aobato/green_pomp4/水中ポンプ部品表.pdf

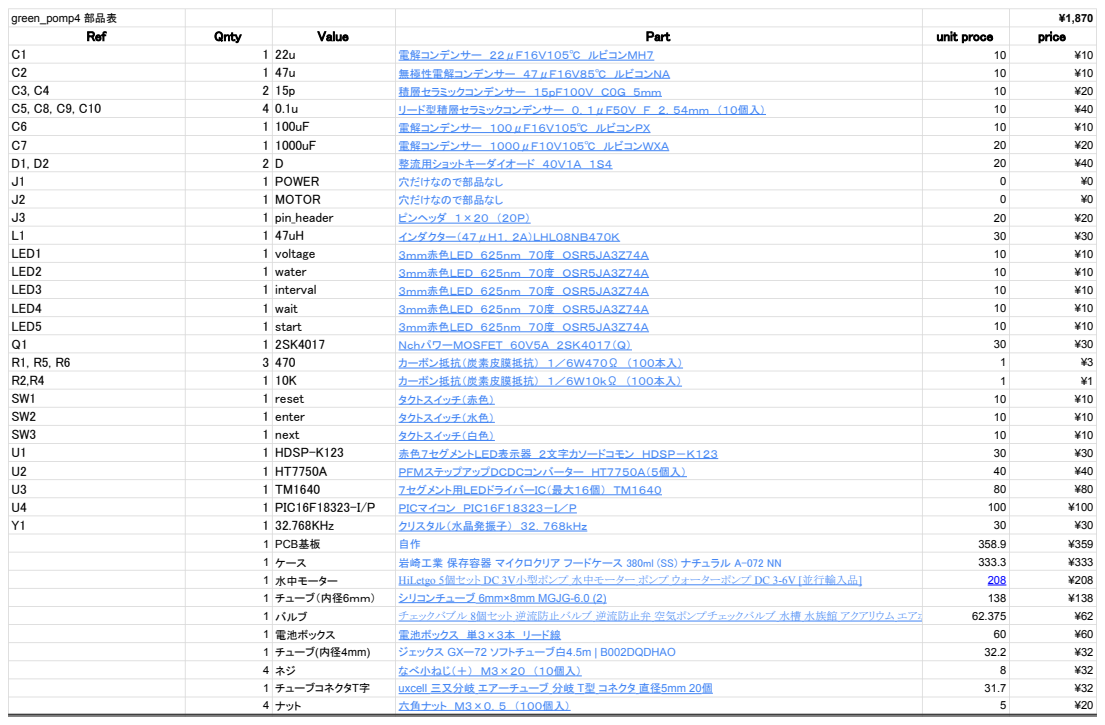
[picture p2: page 1]
green_pomp4 部品表; nty; alue; art; unit proce; price; 電解コンデンサー ２２μＦ１６Ｖ１０５℃ ルビコンＭＨ７; 無極性電解コンデンサー ４７μＦ１６Ｖ８５℃ ルビコンＮＡ; 積層セラミックコンデンサー １５ｐＦ１００Ｖ Ｃ０Ｇ ５ｍｍ; リード型積層セラミックコンデンサー ０．１μＦ５０Ｖ Ｆ ２．５４ｍｍ （１０個入）; 電解コンデンサー １００μＦ１６Ｖ１０５℃ ルビコンＰＸ; 電解コンデンサー １０００μＦ１０Ｖ１０５℃ ルビコンＷＸＡ; 整流用ショットキーダイオード ４０Ｖ１Ａ １Ｓ４; 穴だけなので部品なし; 1 pin_header; ピンヘッダ １×２０ （２０Ｐ）; インダクター（４７μＨ１．２Ａ）ＬＨＬ０８ＮＢ４７０Ｋ; 1 voltage; ３ｍｍ赤色ＬＥＤ ６２５ｎｍ ７０度 ＯＳＲ５ＪＡ３Ｚ７４Ａ; 1 water; 1 interval; 1 wait; 1 start; ＮｃｈパワーＭＯＳＦＥＴ ６０Ｖ５Ａ ２ＳＫ４０１７（Ｑ）; カーボン抵抗（炭素皮膜抵抗） １／６Ｗ４７０Ω （１００本入）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
