aobato/green_pomp4/KiCad/green_pomp4/green_pomp4.pdf

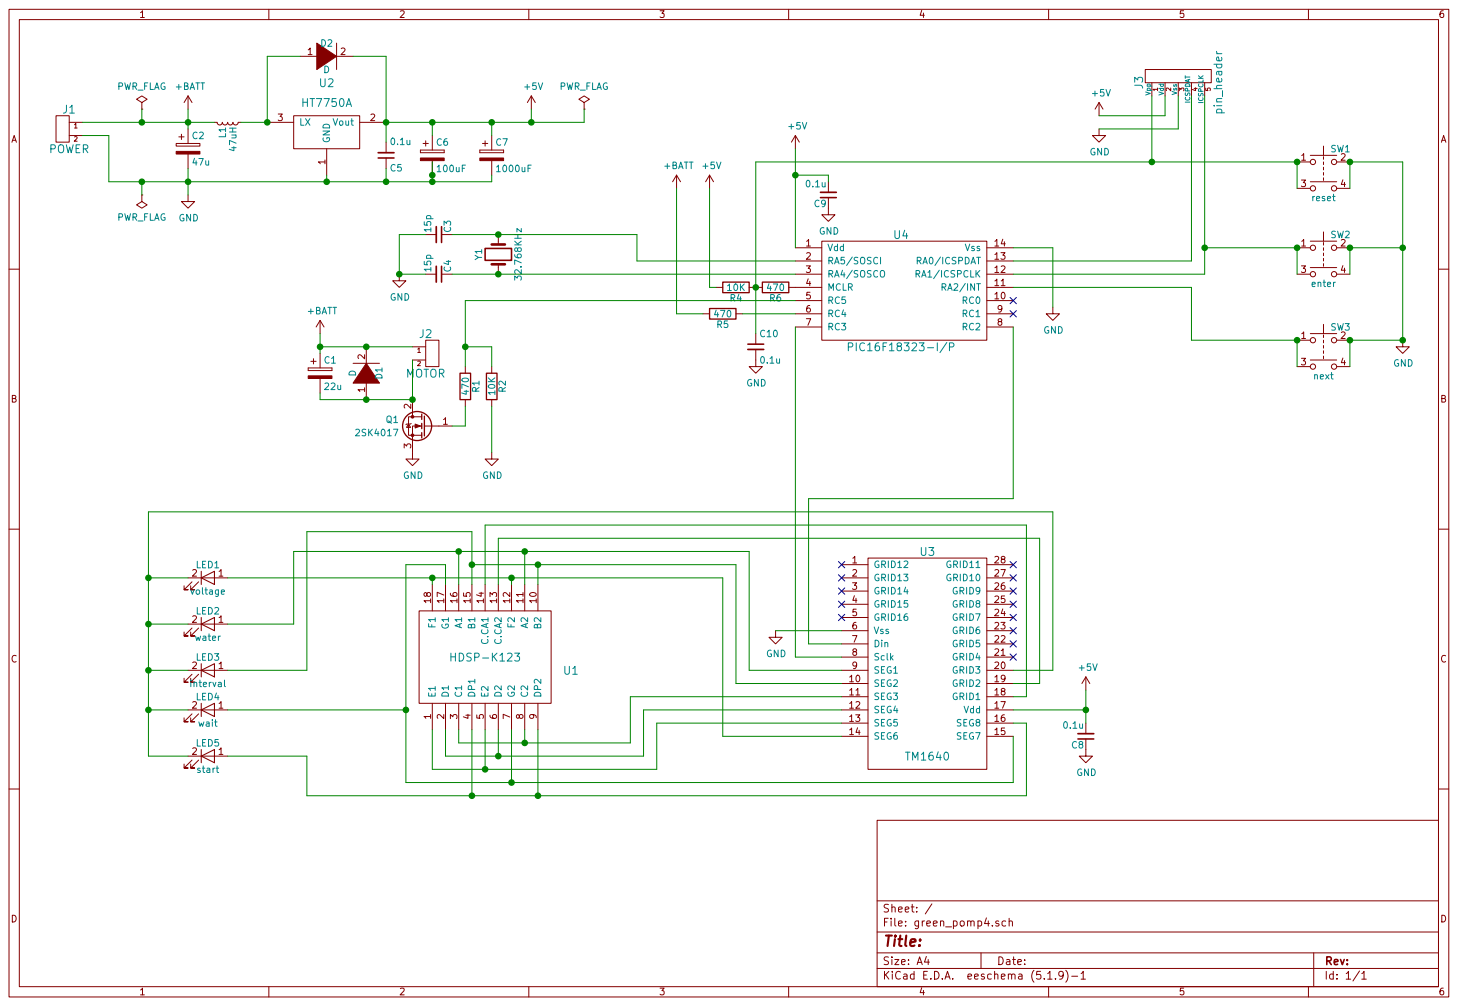
[picture p3: page 1]
