aobato/green_pomp4/(list of files, drawings)

Other design files:
KiCad/green_pomp4/green_pomp3.dsn
