aobato/green_pomp4/KiCad/green_pomp4/green_pomp4.kicad_pcb

## KiCad design KiCad/green_pomp4/green_pomp4.kicad_pcb (2021-12-18)

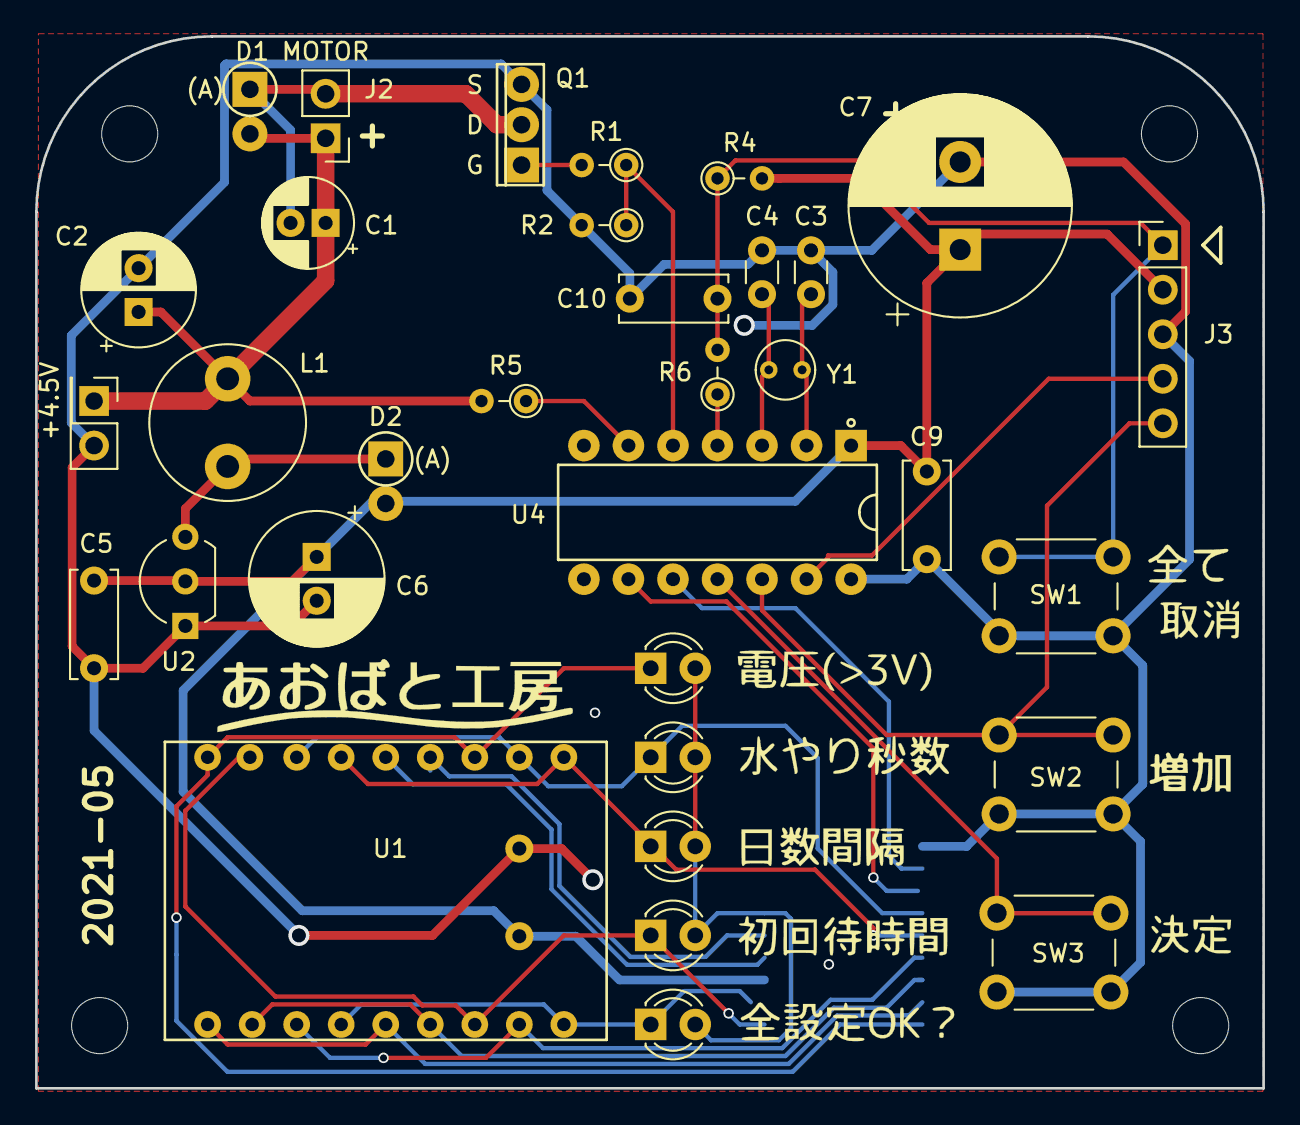
[picture p4: board green_pomp4.kicad_pcb from above]

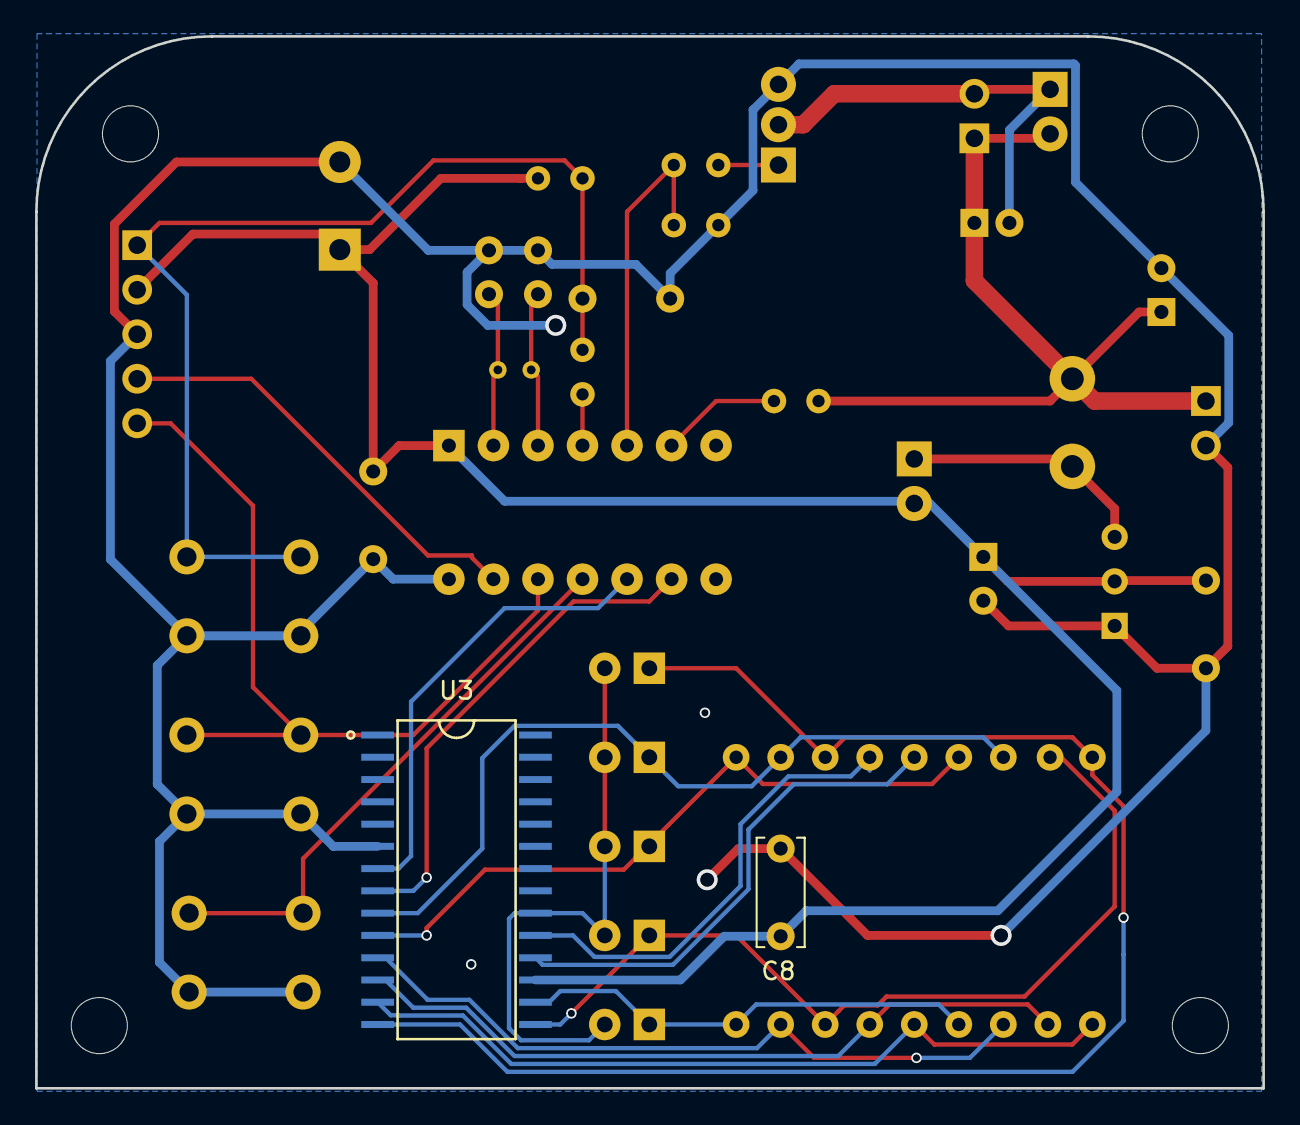
[picture p5: board green_pomp4.kicad_pcb from below]

Board: 2 copper layers, 70.0 x 60.0 mm, 39 parts (2 on the bottom side), 28 nets.

Parts:
C1: 22u; CP_Radial_D5.0mm_P2.00mm
C2: 47u; CP_Radial_D6.3mm_P2.50mm
C3, C4: 15p; C_Disc_D3.0mm_W1.6mm_P2.50mm
C5, C8, C9, C10: 0.1u; C_Disc_D6.0mm_W2.5mm_P5.00mm
C6: 100uF; CP_Radial_D7.5mm_P2.50mm
C7: 1000uF; CP_Radial_D12.5mm_P5.00mm
D1, D2: D; 1S4_V
J1: POWER; PinHeader_2x01_P2.54mm_Vertical
J2: MOTOR; PinHeader_1x02_P2.54mm_Vertical
J3: pin_header; PinHeader_1x05_P2.54mm_Vertical
L1: 47uH; L_Radial_D8.7mm_P5.00mm_Fastron_07HCP
LED1: voltage; LED_D3.0mm
LED2: water; LED_D3.0mm
LED3: interval; LED_D3.0mm
LED4: wait; LED_D3.0mm
LED5: start; LED_D3.0mm
M3 hole, M3 hole#2, M3 hole#3, M3 hole#4: MountingHole_3.2mm_M3
Q1: 2SK4017; 2SK4017_Q
R1, R5, R6: 470; R_Axial_DIN0204_L3.6mm_D1.6mm_P2.54mm_Vertical
R2, R4: 10K; R_Axial_DIN0204_L3.6mm_D1.6mm_P2.54mm_Vertical
SW1: reset; SW_PUSH_6mm
SW2: enter; SW_PUSH_6mm
SW3: next; SW_PUSH_6mm
U1: HDSP-K123
U2: HT7750A; TO-92L_Inline_Wide
U3: TM1640; DSPIC30F2010-20I_SO
U4: PIC16F18323-I/P; PIC16F1503-I_P
Y1: 32.768KHz; Crystal_Round_D3.0mm_Vertical

Connections:
+5V: C5.2, C6.1, C7.1, C8.2, C9.2, D2.2, J3.2, R4.2, U2.2, U3.17, U4.1
+BATT: C1.1, C2.1, D1.2, J1.1, J2.1, L1.1, R5.2
GND: C2.2, C3.2, C4.2, C5.1, C6.2, C7.2, C8.1, C9.1, C10.2, J1.2, J3.3, Q1.3, R2.2, SW1.2, SW2.2, SW3.2, U2.1, U3.6, U4.14
unnamed: C1.2, D1.1, J2.2, Q1.2
unnamed: C3.1, U4.2, Y1.1
unnamed: C4.1, U4.3, Y1.2
unnamed: C10.1, J3.1, R4.1, R6.2, SW1.1
unnamed: D2.1, L1.2, U2.3
unnamed: J3.4, U4.13
unnamed: J3.5, SW2.1, U4.12
unnamed: LED1.1, U1.12, U1.18, U3.14
unnamed: LED1.2, LED2.2, LED3.2, LED4.2, LED5.2, U3.20
unnamed: LED2.1, U1.11, U1.16, U3.9
unnamed: LED3.1, U1.10, U1.15, U3.10
unnamed: LED4.1, U1.7, U1.17, U3.15
unnamed: LED5.1, U1.4, U1.9, U3.16
unnamed: Q1.1, R1.2
unnamed: R1.1, R2.1, U4.5
unnamed: R5.1, U4.6
unnamed: R6.1, U4.4
unnamed: SW3.1, U4.11
unnamed: U1.1, U1.5, U3.13
unnamed: U1.2, U1.6, U3.12
unnamed: U1.3, U1.8, U3.11
unnamed: U1.13, U3.19
unnamed: U1.14, U3.18
unnamed: U3.7, U4.10
unnamed: U3.8, U4.9
