aobato/green_pomp4/KiCad/green_pomp4/green_pomp3.kicad_pcb

## KiCad design KiCad/green_pomp4/green_pomp3.kicad_pcb (2021-12-18)

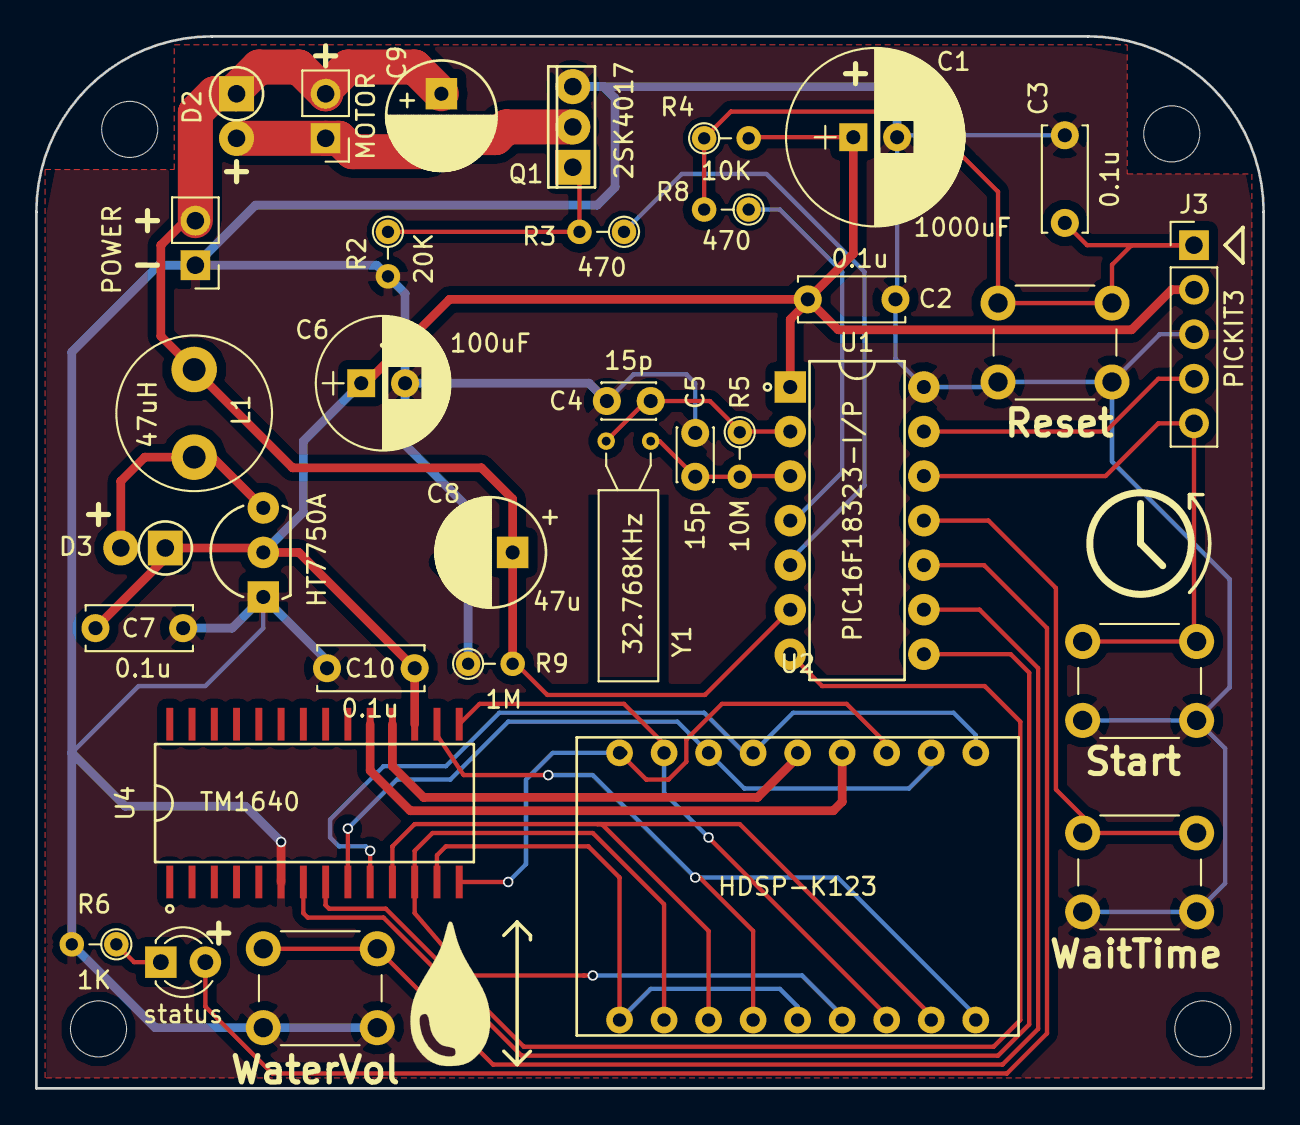
[picture p6: board green_pomp3.kicad_pcb from above]

Board: 2 copper layers, 70.0 x 60.0 mm, 39 parts (0 on the bottom side), 29 nets.

Parts:
C1: 1000uF; CP_Radial_D10.0mm_P2.50mm
C2, C3, C7, C10: 0.1u; C_Disc_D6.0mm_W2.5mm_P5.00mm
C4, C5: 15p; C_Disc_D3.0mm_W2.0mm_P2.50mm
C6: 100uF; CP_Radial_D7.5mm_P2.50mm
C8: 47u; 25PK220MEFC6.3X11
C9: 22u; 25PK220MEFC6.3X11
D2, D3: D; 1S4_V
G1: LOGO; LOGO4
J1: POWER; Pin_Header_Straight_1x02_Pitch2.54mm
J2: MOTOR; Pin_Header_Straight_1x02_Pitch2.54mm
J3: PICKIT3; Pin_Header_Straight_1x05_Pitch2.54mm
L1: 47uH; L_Radial_D8.7mm_P5.00mm_Fastron_07HCP
LED1: status; LED_D3.0mm
Q1: 2SK4017; 2SK4017_Q
R2: 20K; R_Axial_DIN0204_L3.6mm_D1.6mm_P2.54mm_Vertical
R3, R8: 470; R_Axial_DIN0204_L3.6mm_D1.6mm_P2.54mm_Vertical
R4: 10K; R_Axial_DIN0204_L3.6mm_D1.6mm_P2.54mm_Vertical
R5: 10M; R_Axial_DIN0204_L3.6mm_D1.6mm_P2.54mm_Vertical
R6: 1K; R_Axial_DIN0204_L3.6mm_D1.6mm_P2.54mm_Vertical
R9: 1M; R_Axial_DIN0204_L3.6mm_D1.6mm_P2.54mm_Vertical
REF1, REF2, REF3, REF4: MountingHole_3.2mm_M3
SW1: WaitTime; SW_PUSH_6mm
SW2: WaterVol; SW_PUSH_6mm
SW4: Reset; SW_PUSH_6mm
SW5: Start; SW_PUSH_6mm
U1: PIC16F18323-I/P; PIC16F1503-I_P
U2: HDSP-K123
U3: HT7750A; 2N3904BU
U4: TM1640; DSPIC30F2010-20I_SO
Y1: 32.768KHz; Crystal_AT310_d3.0mm_l10.0mm_Horizontal

Connections:
unnamed: C8.1, C9.1, D2.1, J1.2, J2.2, L1.1, R9.2, U1.6
unnamed: C1.2, C2.1, C3.2, C4.2, C5.2, C6.2, C7.1, C8.2, C10.2, J1.1, J3.3, Q1.3, R2.2, R6.2, R9.1, SW1.2, SW2.2, SW4.2, SW5.2, U1.14, U3.1, U4.6
unnamed: C1.1, C2.2, C6.1, C7.2, C10.1, D3.1, J3.2, R4.2, U1.1, U3.2, U4.17
unnamed: C3.1, J3.1, R4.1, R8.2, SW4.1
unnamed: C4.1, R5.1, U1.2, Y1.1
unnamed: C5.1, R5.2, U1.3, Y1.2
unnamed: C9.2, D2.2, J2.1, Q1.2
unnamed: D3.2, L1.2, U3.3
unnamed: J3.4, U1.13
unnamed: J3.5, SW5.1, U1.12
unnamed: LED1.1, R6.1
unnamed: LED1.2, U1.10
unnamed: Q1.1, R2.1, R3.2
unnamed: R3.1, U1.5
unnamed: R8.1, U1.4
unnamed: SW1.1, U1.11
unnamed: SW2.1, U1.9
unnamed: U1.7, U4.8
unnamed: U1.8, U4.7
unnamed: U2.1, U2.5, U4.13
unnamed: U2.2, U2.6, U4.12
unnamed: U2.3, U2.8, U4.11
unnamed: U2.4, U2.9, U4.16
unnamed: U2.10, U2.15, U4.10
unnamed: U2.11, U2.16, U4.9
unnamed: U2.12, U2.18, U4.14
unnamed: U2.13, U4.19
unnamed: U2.14, U4.18
unnamed: U2.7, U2.17, U4.15
