aobato/green_pomp4/(commit log)

2021-12-18 最初の移行
    とりあえずローカルからKicadとMPLABを全部移行
    [green_pomp3-2021-03-14-18-09-07.sch, green_pomp3-2021-04-03-17-11-15.sch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]
2021-12-18 説明書をついか
    説明書をついか
2021-12-18 部品表を追加
    部品表を追加
